Lnxzz/pi_attiny85_switch/(commit log)

2024-03-18 Addition of Arduino sketch
2024-03-18 photo of the switch
